E155-Final-Project/final-project/README.md

# E155 Final Project

Code for both the FPGA (`project_fpga`) and MCU (`project_mcu`).

The project website lives in `website` and is published to https://e155-final-project.github.io/final-project/ whenever changes to it are pushed to `main`.
