E155-Final-Project/final-project/website/posts/bnn-emnist-ice40/diagrams/bnn_network.png

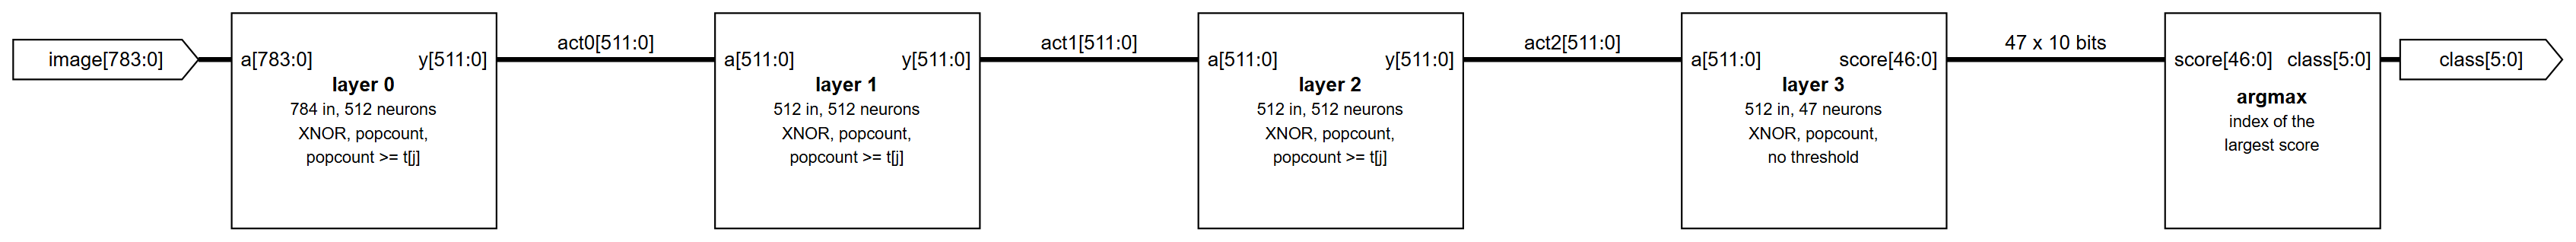
website/posts/bnn-emnist-ice40/diagrams/bnn_network.png
