E155-Final-Project/final-project/BNN/results/depth_sweep.csv

split | hidden | layers | epochs | spram_pct | words | train_last | val | test
balanced | 640-640 | 2 | 60 | 92.7 | 15190 | 0.8523 | 0.8411347270011902 | 0.8344680666923523
balanced | 512-512 | 2 | 60 | 67.9 | 11128 | 0.8382 | 0.8328014016151428 | 0.8326596021652222
balanced | 512-512-512 | 3 | 60 | 92.9 | 15224 | 0.8575 | 0.8455674052238464 | 0.8443617224693298
balanced | 448-448-448-448 | 4 | 60 | 95.0 | 15561 | 0.8554 | 0.846276581287384 | 0.8435638546943665
balanced | 384-384-384-384-384 | 5 | 60 | 88.4 | 14490 | 0.8451 | 0.8405141830444336 | 0.8352659344673157
balanced | 320-320-320-320-320-320-320-320 | 8 | 60 | 95.2 | 15595 | 0.8207 | 0.820035457611084 | 0.8187233805656433
mnist | 640-640 | 2 | 60 | 90.5 | 14820 | 0.9963 | 0.9863333106040955 | 0.9879000186920166
mnist | 512-512 | 2 | 60 | 66.1 | 10832 | 0.9952 | 0.9854999780654907 | 0.9865000247955322
mnist | 512-512-512 | 3 | 60 | 91.1 | 14928 | 0.996 | 0.9851666688919067 | 0.9876999855041504
mnist | 448-448-448-448 | 4 | 60 | 93.4 | 15302 | 0.9946 | 0.9861666560173035 | 0.9843999743461609
mnist | 384-384-384-384-384 | 5 | 60 | 87.1 | 14268 | 0.9924 | 0.9836666584014893 | 0.9843999743461609
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
